blurpy/transistor-tester/documents/comparative_table_for_clone_tester.pdf

## Comparative table for clone ttester

Clone model | CPU(form factor), clock | Display, controller (resolution) | 5V reg., reference 2.5V | Test option (preinstalled firmware) | Protection will measure ports | Firmware, opportunity update | Power supply | Possible price
LCR-T4 | ATMega328 (TQFP) 8Mhz | LCD SPI ST7565 (128x64) | 78L05, Yes,TL431 | Transistors, diodes, diode assemblies, LEDs, thyristors, triacs, zener diodes (<5V), resistors, capacitors, chokes, inductors | No | Chinese firmware (2.07-2.68), possible update to firmware 1.13к or 1.35m | +9V | ≥6-10$

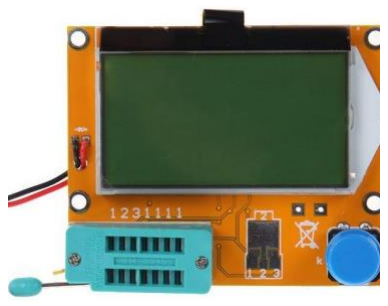
[picture p147: figure]

Fish-8840 | ATMega328 (TQFP) 8Mhz | LCD SPI ST7565 (128x64) | 78L05, No | Transistors, diodes, diode assemblies, LEDs, thyristors, triacs, zener diodes (<5V), resistors, capacitors, chokes, inductors | No | Chinese firmware 2.1, possible update to firmware 1.13к or 1.35m | +9V | ≥15-20$

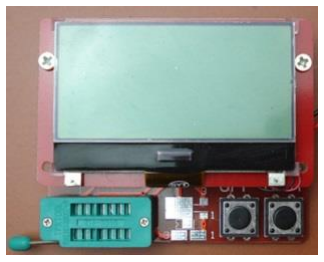
[picture p148: figure]

M328Kit+TFT(AY-AT) | ATMega328 (DIP) 8Mhz | LCD TFT SPI ST7735 (160x128) | 7550, Yes,TL431 | Transistors, diodes, diode assemblies, LEDs, thyristors, triacs, zener diodes (<5V), resistors, capacitors, chokes, inductors voltmeter, frequency generator, frequency meter, encoder | Yes, SRV05-4 diode assembly, suppressor (TVS) 6V8A | Firmware 1.12к mod.*, possible update to firmware 1.13к or 1.35m | +9V, connector ext. 9-12V | ≥10-15$

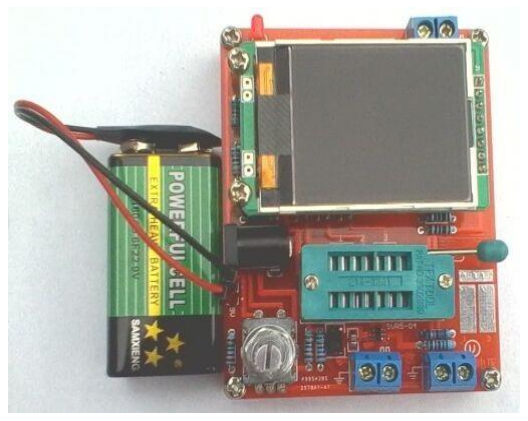
[picture p149: figure]

GM328A | ATMega328 (DIP) 8Mhz | LCD TFT SPI ST7735 (160x128) | 7550, Yes,TL431 | Transistors, diodes, diode assemblies, LEDs, thyristors, triacs, zener diodes (<5V), resistors, capacitors, chokes, inductors voltmeter, frequency generator, frequency meter, encoder | Yes , SRV05 -4 diode assembly, suppressor (TVS) 6V8A | Firmware 1 .12 к mod. * , possible update to firmware 1.13 к or 1.35m | +9 V , connector ext. 9 -12 V | ≥10 -15 $

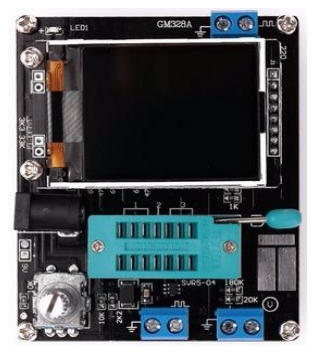
[picture p150: figure]

M328Kit | ATMega328 (DIP) 8Mhz | LCD SPI ST7565 (128x64) | 7550, Yes,TL431 | Transistors, diodes, diode assemblies, LEDs, thyristors, triacs, zener diodes (<5V), resistors, capacitors, chokes, inductors voltmeter, frequency generator, frequency meter, encoder | No | Firmware 1 .12 к mod. * , possible update to firmware 1.13 к or 1.35m | +9 V | ≥10 -15 $

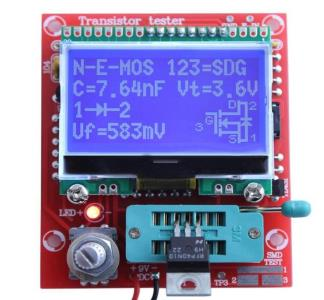
[picture p151: figure]

GM328A+ | ATMega328 (DIP) 8Mhz | LCD SPI ST7565 (128x64) | 7550, Yes,TL431 | Transistors, diodes, diode assemblies, LEDs, thyristors, triacs, zener diodes (<5V), resistors, capacitors, chokes, inductors | Yes , SRV05 -4 diode assembly, suppressor (TVS) 6V8A | Firmware 1.11 к mod. * , possible update to firmware 1.13 к or 1.35m | +9 V | ≥10 -15 $

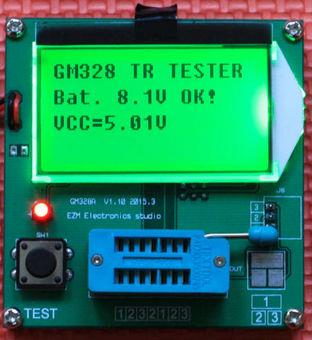
[picture p152: figure]

MG328 | ATMega328 (TQFP) 8Mhz | LCD SPI ST7565 (128x64) | 7150 Yes,TL431 | Transistors, diodes, diode assemblies, LEDs, thyristors, triacs, zener diodes (<5V), resistors, capacitors, chokes, inductors | No | Firmware 1.11 к mod. , possible update to firmware 1.13 к or 1.35m | +3.7 V , +5 V(USB) | $ ≥10 -15

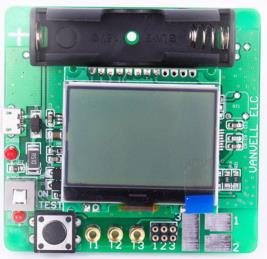
[picture p153: figure]

WEI M8-1 | ATMega328 (TQFP) 8Mhz | LCD SPI ST7565 (128x64) | 7150 Yes,TL431 | Transistors, diodes, diode assemblies, LEDs, thyristors, triacs, zener diodes (<5V), resistors, capacitors, chokes, inductors | No | Firmware 1.11к mod. , possible update to firmware 1.13к or 1.35m | +3.7V, +5V(USB) | ≥10-15$

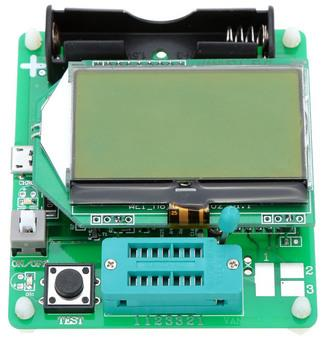
[picture p154: figure]

BSIDE ESR02(DTU-1701B) | ATMega328 (TQFP) 8Mhz | LCD SPI ST7565 (128x64) | 7150 Yes,TL431 | Transistors, diodes, diode assemblies, LEDs, thyristors, triacs, zener diodes (<5V), resistors, capacitors, chokes, inductors | No | Firmware 1.11к mod. , possible update to firmware 1.13к or 1.35m | +9V, connector ext. 9-12V | ≥25-30$
Fish-8840(BOX) | ATMega328 (TQFP) 8Mhz | LCD SPI ST7565 (128x64) | 78L05, No | Transistors, diodes, diode assemblies, LEDs, thyristors, triacs, zener diodes (<5V), resistors, capacitors, chokes, inductors | No | Chinese firmware 2.1, possible update to firmware 1.13к or 1.35m | +9V | ≥10-15$
Fish-8840TFT | ATMega328 (TQFP) 8Mhz | LCD TFT SPI ST7735S (160x128) | 78L05, Yes,TL431 | Transistors, diodes, diode assemblies, LEDs, thyristors, triacs, zener diodes (<5V), resistors, capacitors, chokes, inductors | No | Chinese firmware 2.4*, possible update to firmware 1.13к or 1.35m | +9V | ≥15-20$

LCR-TC1 | ATMega324 (TQFP) 16Mhz | LCD TFT SPI ST7735S (160x128) | 78L05, Yes,TL431 | Transistors, diodes, diode assemblies, LEDs, thyristors, triacs, zener diodes (<35V), voltmeter, resistors, capacitors, chokes, inductors, IR receiver | Yes, SRV05-4 diode assembly, suppressor (TVS) 6V8A | Chinese firmware 2.12*, possible update to firmware 1.13к or 1.35m | +3.7V, USB charging | ≥15-20$

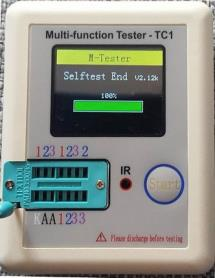
[picture p155: figure]

LCR-T7 | ATMega324 (TQFP) 16Mhz | LCD TFT SPI ST7735S (160x128) | 78L05, Yes,TL431 | Transistors, diodes, diode assemblies, LEDs, thyristors, triacs, zener diodes (<35V), voltmeter, resistors, capacitors, chokes, inductors, IR receiver | Yes, SRV05-4 diode assembly, suppressor (TVS) 6V8A | Chinese firmware 2.12*, possible update to firmware 1.13к or 1.35m ** | +3.7V, USB charging | ≥15-20$

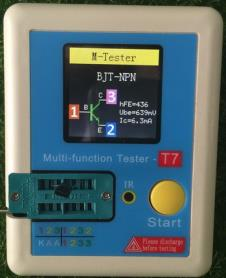
[picture p156: figure]

MK-328 | ATMega328 (TQFP) 8Mhz | LCD SPI ST7565 (128x64) | 1117 Yes,TL431 | Transistors, diodes, diode assemblies, LEDs, thyristors, triacs, zener diodes (<5V), resistors, capacitors, chokes, inductors | Yes, SRV05-4 diode assembly, suppressor (TVS) 6V8A | Firmware 1.11к mod. , possible update to firmware 1.13к or 1.35m | +9V | ≥18-25$
Hiland M644 | ATMega644 (TQFP) 8Mhz | LCD SPI ST7565 (128x64) | 1117 Yes,TL431 | Transistors, diodes, diode assemblies, LEDs, thyristors, triacs, zener diodes (<35V), resistors, capacitors, chokes, inductors, frequency generator, frequency meter, quartz and ceramik resonators, voltmeter, encoder | No | Firmware 1.12к mod.*, possible update to firmware 1.13к or 1.35m | +9V | ≥18-25$

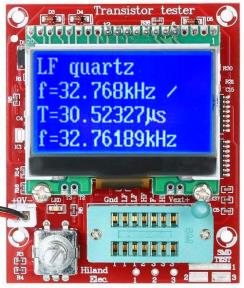
[picture p157: figure]

* Note: the Chinese version is locked to read! | ** Note: for a clone with a display connected to a 6-pin J3 connector.
