blurpy/transistor-tester/(threads)

Thread 1 (2022-02-12):

where to buy just the LCD module ?

janjos0, 2022-02-12:
Hi Christian,
First let me thank you for the detailed description of this specific model of this very popular component tester. It was a pleasure to read. And second I don't have an issue, just a question, please read further.

I have the same tester as you, but mine was bought at DealExtreme.
In fact I have two of them because the first one arrived with a broken LCD. When I asked for a LCD replacement, they just sent me a complete kit. Now I would like to replace the broken LCD but up to now and after searching the www for days I do not find a 100% replacement.

Do you or someone reading this, know a supplier for the LCD ?
Including of course the LCD mounting PCB with the 1117 VREG and CD4050 level translator.

Sorry to ask here but I also asked on the product page of DX and the answer I got was "for the price just buy a all new kit instead of replacing the LCD". I don't think that is really environment friendly if we just trow away stuff that can easily be repaired.
So if someone knows a supplier for the LCD please let me know. Thank you.

blurpy, 2022-02-12:
Hi janjos0,

Thank you, glad to hear!

I agree that it's much better to find a screen replacement if possible. I do not know where to find that exact LCD. Perhaps you can find it somewhere on AliExpress? The firmware supports different kinds of screens, so perhaps another option would be to find another compatible one instead.

I think the eevblog forum would be your best bet in order to find a solution. Have you tried posting here? https://www.eevblog.com/forum/testgear/$20-lcr-esr-transistor-checker-project/

Good luck! If you find a solution, I'll be interested in hearing about it.

blurpy, 2022-02-15:
Ok, thanks for the update anyway!

Closed 2022-02-13.

Thread 2 (2022-03-15):

compiled code not working

gitterman, 2022-03-15:
Hi blurpy,
didn't you need to adapt the pins for the LCD and the rotary encoder?
In your adapted config_328.h you do not mention anything on this.
At least from your supplied schematic, the encoder B pin is different to the default of Markus' firmware.
Also, the 7735 seems to be connected differently.

blurpy, 2022-03-15:
Hi, I have adjusted the configuration for the encoder and the lcd.

See here: https://github.com/blurpy/transistor-tester/commit/e2e808a6cabf67a0e06fa216ab1ddd5512815963

As I write on the page:

> There are 3 configuration files in the firmware that needs to be adjusted. See the file "Clones" (from the firmware tgz) for the basic changes required to build a compatible firmware for the AY-AT. The additional changes I made are documented here.

I did not document the basic changes needed, as they are already documented in the firmware. Do the changes make sense now?

Closed 2022-03-25.

Thread 3 (2023-02-08):

Can you provide precompiled M firmware？

ws786873, 2023-02-08:
I read all your articles and finally found that I couldn't handle the software. It seems that I need to compile it under LINUX. I thought the source code could be burned using ARDUINO, but that's not the case. If possible, please provide a pre-compiled firmware, maybe HEX? So I should be able to burn it in Windows. thank you. If it bothers you, please ignore this problem.

blurpy, 2023-02-08:
Sure, check the firmware folder for v1.42 now. I'm curious if you can get it done from Windows.

ws786873, 2023-02-09:
I use progisp  upload the hex and eep, The software prompts that the burning is successful. Let me try to run it

ws786873, 2023-02-10:
> Sure, check the firmware folder for v1.42 now. I'm curious if you can get it done from Windows.

Hi, my tester will display a white screen after power-on, then display V 1.42M, then display a C in the second line of the voltage, and then insert the capacitor to display the wrong value. Each interval takes tens of seconds.I didn't see any calibration prompt or menu. I don't know where the problem is...

blurpy, 2023-02-10:
Did you flash the correct firmware? I seem to remember something like that when I installed the modified firmware on an unmodified device by mistake.

ws786873, 2023-02-10:
> Did you flash the correct firmware? I seem to remember something like that when I installed the modified firmware on an unmodified device by mistake.

The problem has been solved. I didn't set the fuse configuration correctly before. It needs to be set manually under the WIN system. Now the speed is normal after starting up, and it seems that it can be used correctly. But I still haven't encountered the calibration prompt. Do you have a manual for M firmware? The hyperlink in your article seems to be invalid

blurpy, 2023-02-10:
> The problem has been solved. I didn't set the fuse configuration correctly before.

Good to hear.

> Do you have a manual for M firmware? The hyperlink in your article seems to be invalid

Seems it was deleted. I adjusted the link now so it points to before it was deleted.

Closed 2023-02-14.
