blurpy/transistor-tester/documents/AY-AT-J1.3.pdf

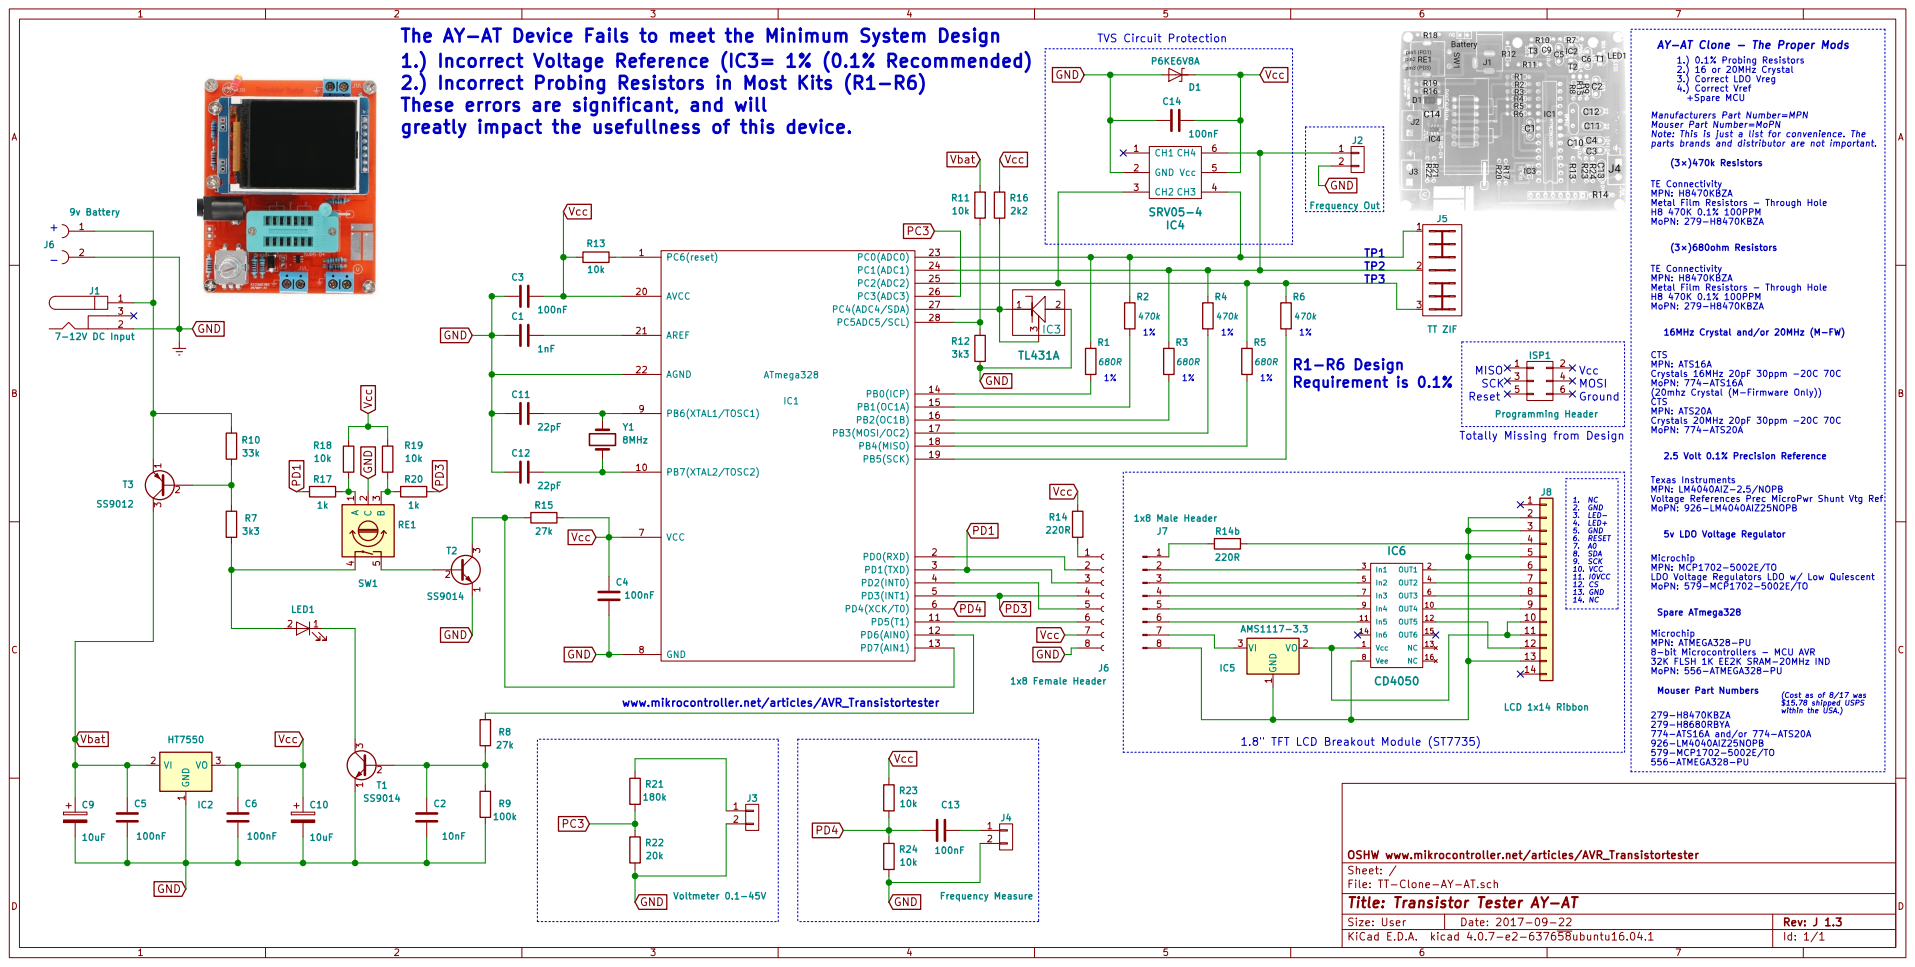
[picture p158: page 1]
