blurpy/transistor-tester/(commit log)

2020-04-12 Switching link to 16mhz crystal on mouser
2020-04-12 Adjust firmware config to my requirements. Disable voltage reference and define 16MHz crystal
2020-04-12 Details about building and flashing the firmware
    [ComponentTester.cfg]
2020-04-13 Added short note about calibration
2021-01-25 Add instructions for in circuit flashing
2021-01-25 Add original firmware v1.12k
    [ComponentTester.cfg]
2021-01-30 Add steps for calibration
2023-02-08 Add config files for unmodified devices as well
